Francerigo/Flux_Gradient_Soil/CO2_gradient/CO2_gradient.ioc

Mcu.UserName=STM32WL55CCUx
PA0.GPIO_Label=SOILTH_ONOFF
PA0.Signal=GPIO_Output
PA1.Signal=SPI1_SCK
PA11.GPIO_Label=MUXADC_EN
PA11.Signal=GPIO_Output
PA12.Signal=I2C2_SCL
PA15.Signal=I2C2_SDA
PA2.Signal=USART2_TX
PA3.Signal=USART2_RX
PA4.GPIO_Label=CS_SD
PA4.Signal=GPIO_Output
PA5.GPIO_Label=MOS_SD_ONOFF
PA5.Signal=GPIO_Output
PA6.Signal=SPI1_MISO
PA8.GPIO_Label=MUXCO2_EN
PA8.Signal=GPIO_Output
PA9.GPIO_Label=MUX_A0
PA9.Signal=GPIO_Output
PB0-VDD_TCXO.Signal=VDDTCXO
PB12.Signal=GPIO_Output
PB2.Signal=ADC_IN4
PB3.GPIO_Label=MUX_A1
PB3.Signal=GPIO_Output
PB4.GPIO_Label=MUX_A2
PB4.Signal=GPIO_Output
PB5.Signal=SPI1_MOSI
PB6.Signal=USART1_TX
PB7.Signal=USART1_RX
PC14-OSC32_IN.Signal=RCC_OSC32_IN
PC15-OSC32_OUT.Signal=RCC_OSC32_OUT
