Francerigo/Flux_Gradient_Soil/CO2_gradient/Core/Inc/main.h

#define RTC_N_PREDIV_S 10
#define RTC_PREDIV_S ((1<<RTC_N_PREDIV_S)-1)
#define RTC_PREDIV_A ((1<<(15-RTC_N_PREDIV_S))-1)
#define MUX_A1_Pin GPIO_PIN_3
#define MUX_A1_GPIO_Port GPIOB
#define MUX_A2_Pin GPIO_PIN_4
#define MUX_A2_GPIO_Port GPIOB
#define SOILTH_ONOFF_Pin GPIO_PIN_0
#define SOILTH_ONOFF_GPIO_Port GPIOA
#define CS_SD_Pin GPIO_PIN_4
#define CS_SD_GPIO_Port GPIOA
#define MOS_SD_ONOFF_Pin GPIO_PIN_5
#define MOS_SD_ONOFF_GPIO_Port GPIOA
#define MUXCO2_EN_Pin GPIO_PIN_8
#define MUXCO2_EN_GPIO_Port GPIOA
#define MUX_A0_Pin GPIO_PIN_9
#define MUX_A0_GPIO_Port GPIOA
#define MUXADC_EN_Pin GPIO_PIN_11
#define MUXADC_EN_GPIO_Port GPIOA
