Francerigo/Flux_Gradient_Soil/CO2_gradient/Core/Src/usart_if.c

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

/* Includes ------------------------------------------------------------------*/
#include "usart_if.h"

/* USER CODE BEGIN Includes */
//#include "lora_app.c"
#include "string.h"
#include "stdlib.h"
#include "stdio.h"
#include "stm32_seq.h"

/* USER CODE END Includes */

/* External variables ---------------------------------------------------------*/
/**
  * @brief DMA handle
  */
extern DMA_HandleTypeDef hdma_usart2_tx;

/**
  * @brief UART handle
  */
extern UART_HandleTypeDef huart2;

/**
  * @brief buffer to receive 1 character
  */
uint8_t charRx;

/**
  * @brief Trace driver callbacks handler
  */
const UTIL_ADV_TRACE_Driver_s UTIL_TraceDriver =
{
  vcom_Init,
  vcom_DeInit,
  vcom_ReceiveInit,
  vcom_Trace_DMA,
};

/**
  * @brief  TX complete callback
  * @return none
  */
static void (*TxCpltCallback)(void *);
/**
  * @brief  RX complete callback
  * @param  rxChar ptr of chars buffer sent by user
  * @param  size buffer size
  * @param  error errorcode
  * @return none
  */
static void (*RxCpltCallback)(uint8_t *rxChar, uint16_t size, uint8_t error);


/* Exported functions --------------------------------------------------------*/

UTIL_ADV_TRACE_Status_t vcom_Init(void (*cb)(void *))
{
  TxCpltCallback = cb;
  MX_DMA_Init();
  MX_USART2_UART_Init();
  LL_EXTI_EnableIT_0_31(LL_EXTI_LINE_27);
  return UTIL_ADV_TRACE_OK;
}

UTIL_ADV_TRACE_Status_t vcom_DeInit(void)
{
  /* ##-1- Reset peripherals ################################################## */
  __HAL_RCC_USART2_FORCE_RESET();
  __HAL_RCC_USART2_RELEASE_RESET();

  /* ##-2- MspDeInit ################################################## */
  HAL_UART_MspDeInit(&huart2);

  /* ##-3- Disable the NVIC for DMA ########################################### */
  /* USER CODE BEGIN 1 */
  HAL_NVIC_DisableIRQ(DMA1_Channel5_IRQn);

  return UTIL_ADV_TRACE_OK;
  /* USER CODE END 1 */
}

void vcom_Trace(uint8_t *p_data, uint16_t size)
{
  HAL_UART_Transmit(&huart2, p_data, size, 1000);
}

UTIL_ADV_TRACE_Status_t vcom_Trace_DMA(uint8_t *p_data, uint16_t size)
{
  HAL_UART_Transmit_DMA(&huart2, p_data, size);
  return UTIL_ADV_TRACE_OK;
}

UTIL_ADV_TRACE_Status_t vcom_ReceiveInit(void (*RxCb)(uint8_t *rxChar, uint16_t size, uint8_t error))
{
  UART_WakeUpTypeDef WakeUpSelection;

  /*record call back*/
  RxCpltCallback = RxCb;

  /*Set wakeUp event on start bit*/
  WakeUpSelection.WakeUpEvent = UART_WAKEUP_ON_STARTBIT;

  HAL_UARTEx_StopModeWakeUpSourceConfig(&huart2, WakeUpSelection);

  /* Make sure that no UART transfer is on-going */
  while (__HAL_UART_GET_FLAG(&huart2, USART_ISR_BUSY) == SET);

  /* Make sure that UART is ready to receive)   */
  while (__HAL_UART_GET_FLAG(&huart2, USART_ISR_REACK) == RESET);

  /* Enable USART interrupt */
  __HAL_UART_ENABLE_IT(&huart2, UART_IT_WUF);

  /*Enable wakeup from stop mode*/
  HAL_UARTEx_EnableStopMode(&huart2);

  /*Start LPUART receive on IT*/
  HAL_UART_Receive_IT(&huart2, &charRx, 1);

  return UTIL_ADV_TRACE_OK;
}

void vcom_Resume(void)
{
  /*to re-enable lost UART settings*/
  if (HAL_UART_Init(&huart2) != HAL_OK)
  {
    Error_Handler();
  }

  /*to re-enable lost DMA settings*/
  if (HAL_DMA_Init(&hdma_usart2_tx) != HAL_OK)
  {
    Error_Handler();
  }
  /* USER CODE BEGIN vcom_Resume_2 */
  if (HAL_UART_Init(&huart1) != HAL_OK)
  {
    Error_Handler();
  }

  /* USER CODE END vcom_Resume_2 */
}

void HAL_UART_TxCpltCallback(UART_HandleTypeDef *huart)
{
  /* buffer transmission complete*/
  if (huart->Instance == USART2)
  {
    TxCpltCallback(NULL);
  }
}

void HAL_UART_RxCpltCallback(UART_HandleTypeDef *huart)
{
  /* USER CODE BEGIN HAL_UART_RxCpltCallback_1 */
	if (huart->Instance == USART1){
		UTIL_SEQ_SetTask((1 << CFG_SEQ_Task_USART1), CFG_SEQ_Prio_0);
		return;
	}

	if (huart->Instance == USART2){
		UTIL_SEQ_SetTask((1 << CFG_SEQ_Task_USART2), CFG_SEQ_Prio_0);
		return;
	}
  /* USER CODE END HAL_UART_RxCpltCallback_1 */
  if (huart->Instance == USART2)
  {
    if ((NULL != RxCpltCallback) && (HAL_UART_ERROR_NONE == huart->ErrorCode))
    {
      RxCpltCallback(&charRx, 1, 0);
    }
    HAL_UART_Receive_IT(huart, &charRx, 1);
  }
}
