Francerigo/Flux_Gradient_Soil/CO2_gradient/Core/Src/stm32_lpm_if.c

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

/* Includes ------------------------------------------------------------------*/
#include "platform.h"
#include "stm32_lpm.h"
#include "stm32_lpm_if.h"
#include "usart_if.h"

/* USER CODE BEGIN Includes */
#include "adc.h"
#include "app_fatfs.h"
#include "i2c.h"
#include "spi.h"
#include "app_lorawan.h"
#include "lora_app.h"
#include "sys_app.h"
#include "stm32_seq.h"
#include "gpio.h"
/* USER CODE END Includes */

/* External variables ---------------------------------------------------------*/
/**
  * @brief Power driver callbacks handler
  */
const struct UTIL_LPM_Driver_s UTIL_PowerDriver =
{
  PWR_EnterSleepMode,
  PWR_ExitSleepMode,

  PWR_EnterStopMode,
  PWR_ExitStopMode,

  PWR_EnterOffMode,
  PWR_ExitOffMode,
};

/* Exported functions --------------------------------------------------------*/

void PWR_EnterOffMode(void)
{
}

void PWR_ExitOffMode(void)
{
}

void PWR_EnterStopMode(void)
{
  HAL_SuspendTick();
  /* Clear Status Flag before entering STOP/STANDBY Mode */
  LL_PWR_ClearFlag_C1STOP_C1STB();

  /* USER CODE BEGIN EnterStopMode_2 */
  HAL_UART_Transmit(&huart2, (uint8_t*)("ES\r\n"), 4, 0xFFFF);
  HAL_GPIO_WritePin(GPIOA, MUXCO2_EN_Pin, GPIO_PIN_RESET);
  /* USER CODE END EnterStopMode_2 */
  HAL_PWREx_EnterSTOP2Mode(PWR_STOPENTRY_WFI);
}

void PWR_ExitStopMode(void)
{
  /* Resume sysTick : work around for debugger problem in dual core */
  HAL_ResumeTick();
  /*Not retained periph:
    ADC interface
    DAC interface USARTx, TIMx, i2Cx, SPIx
    SRAM ctrls, DMAx, DMAMux, AES, RNG, HSEM  */

  /* Resume not retained USARTx and DMA */
  vcom_Resume();
  /* USER CODE BEGIN ExitStopMode_2 */
  //MX_ADC_Init();
  MX_I2C2_Init();

  /* USER CODE END ExitStopMode_2 */
}

void PWR_EnterSleepMode(void)
{
  /* Suspend sysTick */
  HAL_SuspendTick();
  HAL_PWR_EnterSLEEPMode(PWR_MAINREGULATOR_ON, PWR_SLEEPENTRY_WFI);
}

void PWR_ExitSleepMode(void)
{
  /* Resume sysTick */
  HAL_ResumeTick();

}
