Francerigo/Flux_Gradient_Soil/(commit log)

2026-04-28 updated timer overflow on sd card logging
2026-05-28 updated working code before the addition of the reading of the fourth co2 sensor for atmospheric reference
2026-10-13 Update PCB images
