Francerigo/Flux_Gradient_Soil/(notices)

Notices in the files:
CO2_gradient/Core/Src/usart_if.c:
Copyright (c) 2025 STMicroelectronics.
All rights reserved.
This software is licensed under terms that can be found in the LICENSE file
CO2_gradient/Core/Inc/main.h:
Copyright (c) 2026 STMicroelectronics.
CO2_gradient/LoRaWAN/App/lora_app.c:
Copyright (c) 2021 STMicroelectronics.
